ahnjaekwan/Sensor-Racing-Car/Sensors.jpg

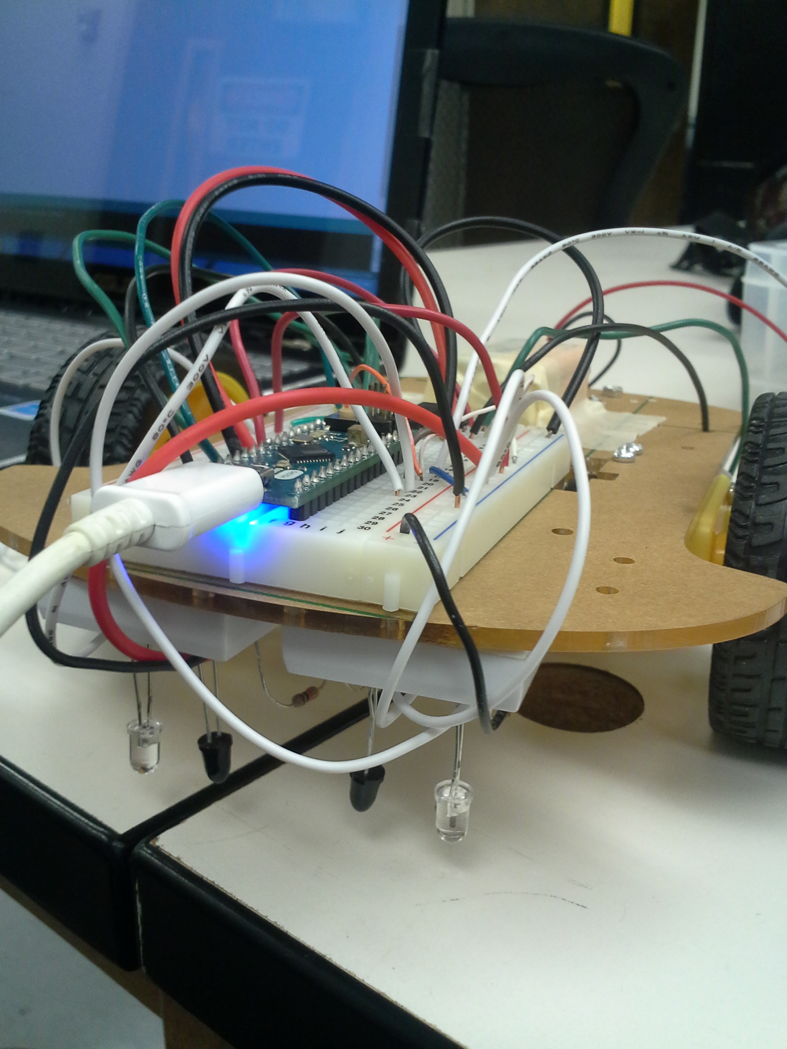
Sensors.jpg
